Eptaz/Pixel-Chase/Plans/Assemblage_2.jpg

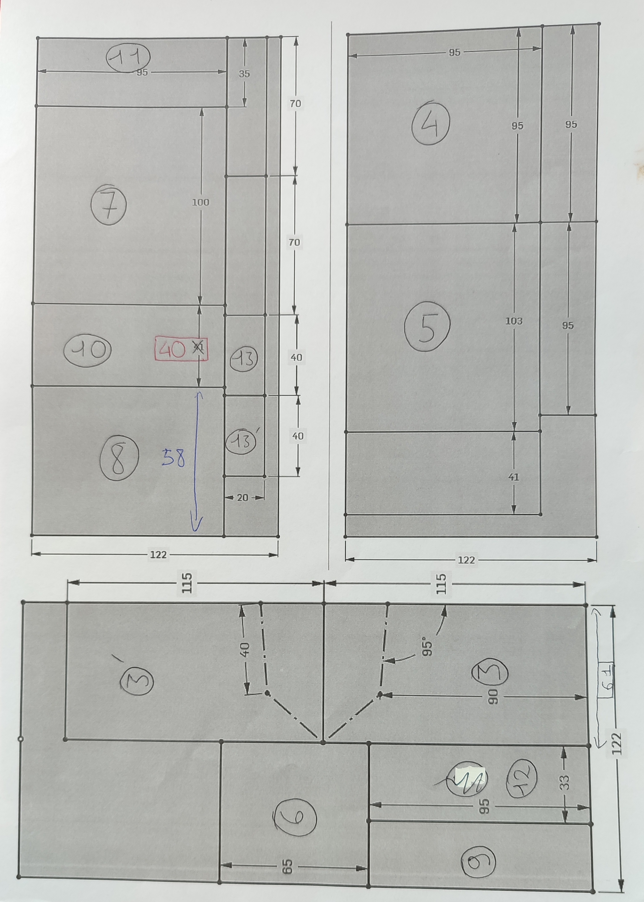
Plans/Assemblage_2.jpg
