Eptaz/Pixel-Chase/Plans/Assemblage_1.jpg

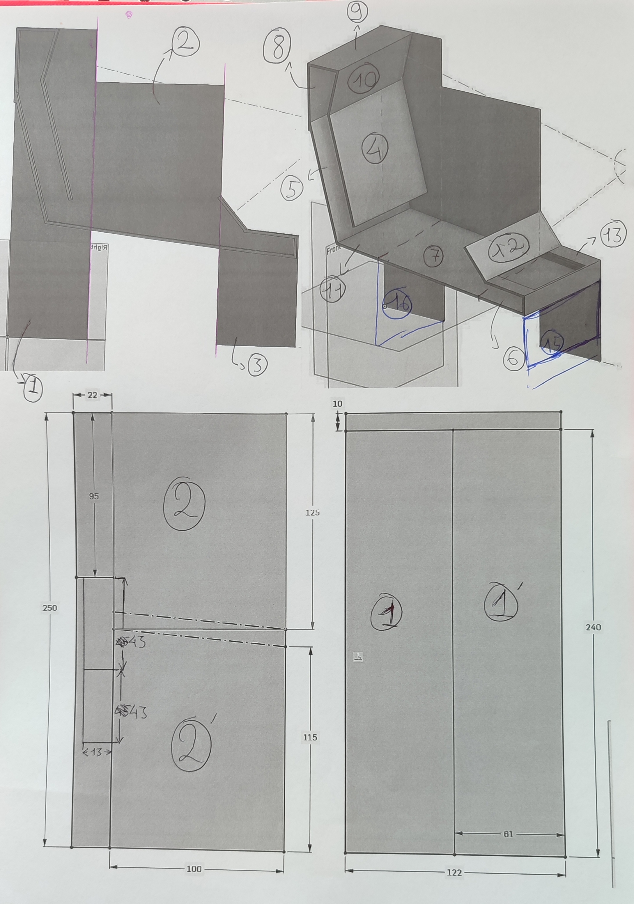
Plans/Assemblage_1.jpg
