Eptaz/Pixel-Chase/README.md

Polytech project leaded by @Rapha-tech and @Eptaz

Creating an Arcade Game named Pixel Chase.
