Eptaz/Pixel-Chase/Plans/plan pixel chase.pdf

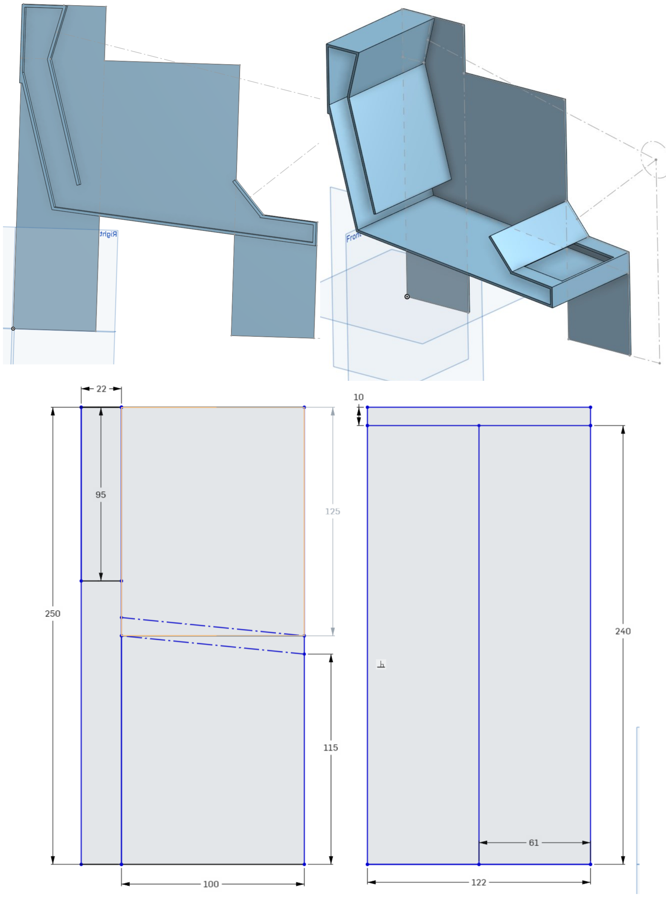
[picture p3: page 1]
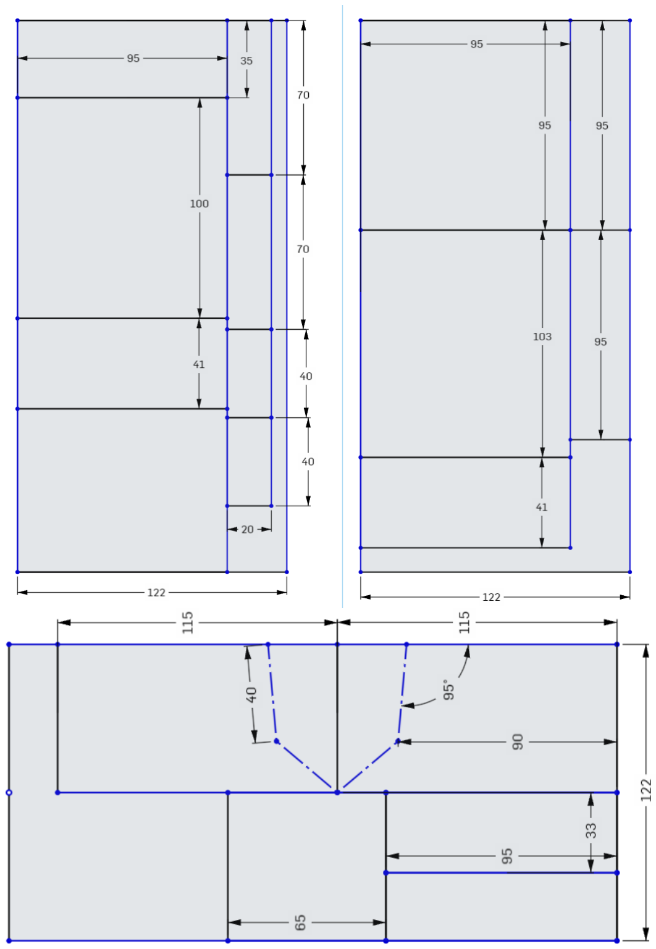
[picture p4: page 2]
