Eptaz/Pixel-Chase/planches.xlsx

id | taille | quantité | contreplaqué de 10mm
1 | 110*150 | 2 | OU MDF de 15mm
2 | 95*95 | 1
3 | 105*95 | 1
4 | 80*95 | 1
5 | 27*95 | 1
6 | 25*95 | 1
7 | 45*95 | 1
8 | 20*95 | 1
9 | 25*95 | 1
