Eptaz/Pixel-Chase/Carte_mere_pixel_chase/Carte_mere_pixel_chase.kicad_pcb

## KiCad design Carte_mere_pixel_chase/Carte_mere_pixel_chase.kicad_pcb (2025-05-08)

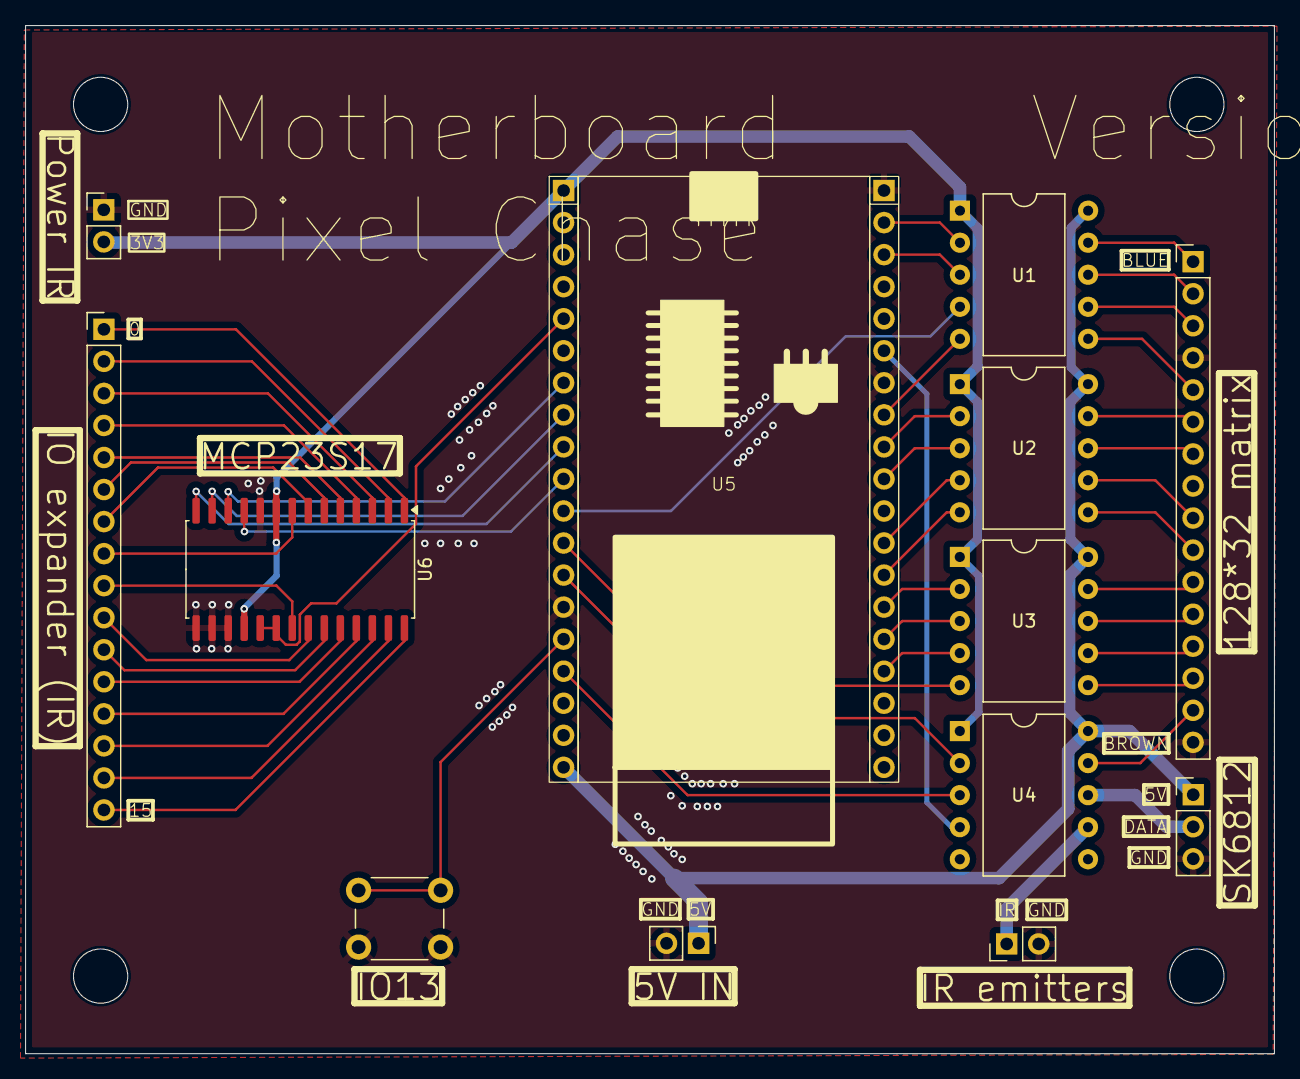
[picture p5: board Carte_mere_pixel_chase.kicad_pcb from above]

Board: 2 copper layers, 99.0 x 81.5 mm, 17 parts (0 on the bottom side), 55 nets.

Parts:
H1, H2, H3, H4: MountingHole; MountingHole_4.3mm_M4
J1: Conn_01x02_5V_IN; PinHeader_1x02_P2.54mm_Vertical
J2: Conn_01x16_Matrix; PinHeader_1x16_P2.54mm_Vertical
J3: Conn_01x03_SK6812; PinHeader_1x03_P2.54mm_Vertical
J4: Conn_01x16_IR_receivers; PinHeader_1x16_P2.54mm_Vertical
J5: Conn_01x02_3V3+GND IR_receivers; PinHeader_1x02_P2.54mm_Vertical
J6: Conn_01x02_IR_emitters; PinHeader_1x02_P2.54mm_Vertical
SW1: SW_Push; SW_PUSH_6mm
U1, U2, U3, U4: DIP-10_W10.16mm
U5: ESP32-S3 dev module; esp32 dev module
U6: MCP23S17_SO; SOIC-28W_7.5x17.9mm_P1.27mm

Connections:
+3V3: J5.1, U1.1 (LV), U2.1 (LV), U3.1 (LV), U4.1 (LV), U5.1 (3V3), U6.9 (VDD), U6.18 (~RESET)
+5V: J1.1, J3.1, U1.10 (HV), U2.10 (HV), U3.10 (HV), U4.10 (HV), U5.19 (5V)
B0: U1.4 (L3), U5.11 (D27)
GND: J1.2, J2.4, J2.16, J3.3, J5.2, J6.2, SW1.1, U5.14 (GND), U5.20 (GND), U5.26 (GND), U6.10 (VSS), U6.15 (A0), U6.16 (A1), U6.17 (A2)
INTERRUPT: U5.5 (D34), U6.19 (INTB), U6.20 (INTA)
IR_LED: U4.4 (L3), U5.25 (D21)
LATCH: U3.5 (L4), U5.12 (D14)
unnamed: J2.1, U1.9 (H1)
unnamed: J2.2, U1.8 (H2)
unnamed: J2.3, U1.7 (H3)
unnamed: J2.5, U1.6 (H4)
unnamed: J2.6, U2.9 (H1)
unnamed: J2.7, U2.8 (H2)
unnamed: J2.9, U2.7 (H3)
unnamed: J2.10, U2.6 (H4)
unnamed: J2.11, U3.9 (H1)
unnamed: J2.12, U3.8 (H2)
unnamed: J2.13, U3.7 (H3)
unnamed: J2.14, U3.6 (H4)
unnamed: J2.15, U4.9 (H1)
unnamed: J3.2, U4.8 (H2)
unnamed: J4.1, U6.1 (GPB0)
unnamed: J4.2, U6.2 (GPB1)
unnamed: J4.3, U6.3 (GPB2)
unnamed: J4.4, U6.4 (GPB3)
unnamed: J4.5, U6.5 (GPB4)
unnamed: J4.6, U6.6 (GPB5)
unnamed: J4.7, U6.7 (GPB6)
unnamed: J4.8, U6.8 (GPB7)
unnamed: J4.9, U6.21 (GPA0)
unnamed: J4.10, U6.22 (GPA1)
unnamed: J4.11, U6.23 (GPA2)
unnamed: J4.12, U6.24 (GPA3)
unnamed: J4.13, U6.25 (GPA4)
unnamed: J4.14, U6.26 (GPA5)
unnamed: J4.15, U6.27 (GPA6)
unnamed: J4.16, U6.28 (GPA7)
unnamed: J6.1, U4.7 (H3)
unnamed: U1.2 (L1), U5.21 (D23)
unnamed: U1.3 (L2), U5.22 (D22)
unnamed: U1.5 (L4), U5.27 (D19)
unnamed: U2.2 (L1), U5.28 (D18)
unnamed: U2.3 (L2), U5.29 (D5)
unnamed: U2.4 (L3), U5.31 (D16)
unnamed: U2.5 (L4), U5.32 (D4)
unnamed: U3.2 (L1), U5.33 (D0)
unnamed: U3.3 (L2), U5.34 (D2)
unnamed: U3.4 (L3), U5.35 (D15)
unnamed: SW1.2, U5.15 (D13)
OE: U4.2 (L1), U5.13 (D12)
SK6812: U4.3 (L2), U5.16 (D2)
SPI_CS: U5.10 (D26), U6.11 (~CS)
SPI_MISO: U5.8 (D33), U6.13 (SI)
SPI_MOSI: U5.9 (D25), U6.14 (SO)
SPI_SCK: U5.7 (D32), U6.12 (SCK)
